mpkendall/orph-pico-reloaded/orphkicad.kicad_pcb

## KiCad design orphkicad.kicad_pcb (2026-01-25)

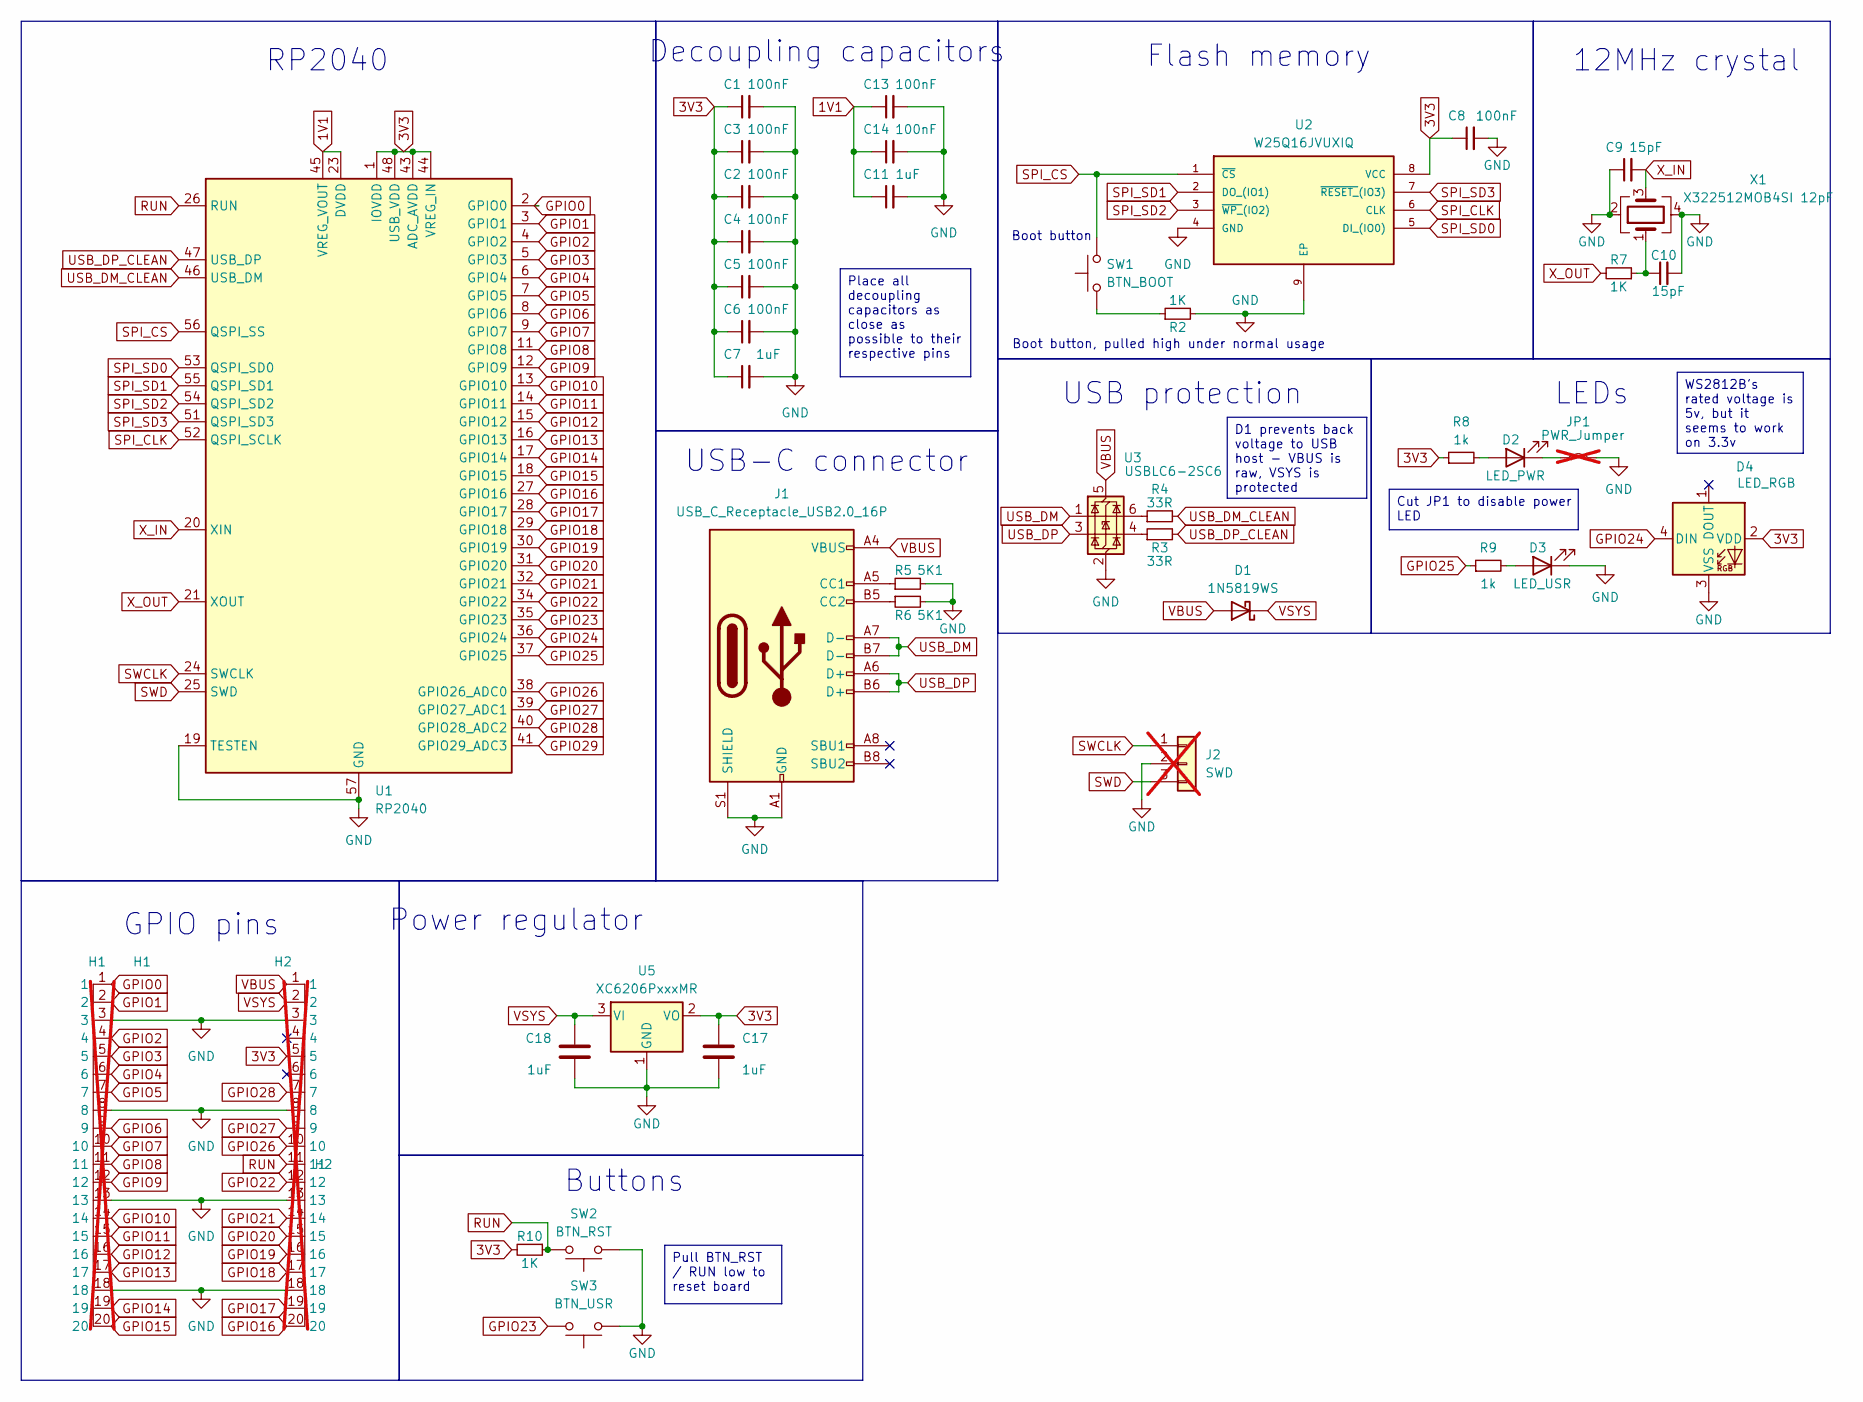
[picture p1: schematic orphkicad.kicad_sch, Orpheus Pico]

Parts:
C1, C2, C3, C4, C5, C6, C8, C13, C14: 100nF; C_0402_1005Metric; LCSC C1525
C7, C11, C17, C18: 1uF; C_0402_1005Metric; LCSC C52923
C9, C10: 15pF; C_0402_1005Metric; LCSC C1548
D1: 1N5819WS; D_SOD-323; LCSC C191023
D2: LED_PWR; LED_0603_1608Metric; LCSC C2286
D3: LED_USR; LED_0603_1608Metric; LCSC C2286
D4: LED_RGB; LED-SMD_4P-L1.6-W1.5_XL-1615RGBC-WS2812B; LCSC C5349954
H1: H1; OrphPicoHeaders; not fitted
H2: H2; OrphPicoHeaders; not fitted
J1: USB_C_Receptacle_USB2.0_16P; USB-C-SMD_TYPE-C-6PIN-2MD-073; LCSC C2765186
J2: SWD; PinHeader_1x03_P2.54mm_Vertical; not fitted
JP1: PWR_Jumper; SolderJumper-2_P1.3mm_Bridged2Bar_RoundedPad1.0x1.5mm; not fitted
R2, R7, R10: 1K; R_0402_1005Metric; LCSC C11702
R3, R4: 33R; R_0402_1005Metric; LCSC C25105
R5, R6: 5K1; R_0402_1005Metric; LCSC C25905
R8, R9: 1k; R_0402_1005Metric; LCSC C11702
SW1: BTN_BOOT; SW-SMD_L3.9-W3.0-P4.45; LCSC C455280
SW2: BTN_RST; SW-SMD_L3.9-W3.0-P4.45; LCSC C455280
SW3: BTN_USR; SW-SMD_L3.9-W3.0-P4.45; LCSC C455280
U1: RP2040; QFN-56-1EP_7x7mm_P0.4mm_EP3.2x3.2mm; LCSC C2040
U2: W25Q16JVUXIQ; Winbond_USON-8-1EP_3x2mm_P0.5mm_EP0.2x1.6mm; MANUFACTURER_PART_NUMBER W25Q16JVUXIQ; LCSC C2843335
U3: USBLC6-2SC6; SOT-23-6; LCSC C5180249
U5: XC6206PxxxMR; SOT-23-3; LCSC C5446
X1: X322512MOB4SI 12pF; Crystal_SMD_3225-4Pin_3.2x2.5mm; LCSC C70565

Connections:
1V1: C11.1, C13.1, C14.1, U1.23 (DVDD), U1.45 (VREG_VOUT), U1.50 (DVDD)
3V3: C1.1, C2.1, C3.1, C4.1, C5.1, C6.1, C7.1, C8.1, C17.1, D4.2 (VDD), H2.5, R8.1, R10.2, U1.1 (IOVDD), U1.10 (IOVDD), U1.22 (IOVDD), U1.33 (IOVDD), U1.42 (IOVDD), U1.43 (ADC_AVDD), U1.44 (VREG_IN), U1.48 (USB_VDD), U1.49 (IOVDD), U2.8 (VCC), U5.2 (VO)
GND: C1.2, C2.2, C3.2, C4.2, C5.2, C6.2, C7.2, C8.2, C9.1, C10.2, C11.2, C13.2, C14.2, C17.2, C18.2, D3.1 (K), D4.3 (VSS), H1.3, H1.8, H1.13, H1.18, H2.3, H2.8, H2.13, H2.18, J1.A1 (GND), J1.B1 (GND), J1.S1 (SHIELD), J2.2, JP1.2 (B), R2.2, R5.2, R6.2, SW2.1, SW3.1, U1.19 (TESTEN), U1.57 (GND), U2.4 (GND), U2.9 (EP), U3.2 (GND), U5.1 (GND), X1.2, X1.4
GPIO0: H1.1, U1.2 (GPIO0)
GPIO1: H1.2, U1.3 (GPIO1)
GPIO2: H1.4, U1.4 (GPIO2)
GPIO3: H1.5, U1.5 (GPIO3)
GPIO4: H1.6, U1.6 (GPIO4)
GPIO5: H1.7, U1.7 (GPIO5)
GPIO6: H1.9, U1.8 (GPIO6)
GPIO7: H1.10, U1.9 (GPIO7)
GPIO8: H1.11, U1.11 (GPIO8)
GPIO9: H1.12, U1.12 (GPIO9)
GPIO10: H1.14, U1.13 (GPIO10)
GPIO11: H1.15, U1.14 (GPIO11)
GPIO12: H1.16, U1.15 (GPIO12)
GPIO13: H1.17, U1.16 (GPIO13)
GPIO14: H1.19, U1.17 (GPIO14)
GPIO15: H1.20, U1.18 (GPIO15)
GPIO16: H2.20, U1.27 (GPIO16)
GPIO17: H2.19, U1.28 (GPIO17)
GPIO18: H2.17, U1.29 (GPIO18)
GPIO19: H2.16, U1.30 (GPIO19)
GPIO20: H2.15, U1.31 (GPIO20)
GPIO21: H2.14, U1.32 (GPIO21)
GPIO22: H2.12, U1.34 (GPIO22)
GPIO23: SW3.2, U1.35 (GPIO23)
GPIO24: D4.4 (DIN), U1.36 (GPIO24)
GPIO25: R9.1, U1.37 (GPIO25)
GPIO26: H2.10, U1.38 (GPIO26_ADC0)
GPIO27: H2.9, U1.39 (GPIO27_ADC1)
GPIO28: H2.7, U1.40 (GPIO28_ADC2)
GPIO29: U1.41 (GPIO29_ADC3)
unnamed: C10.1, R7.1, X1.1
unnamed: D2.2 (A), R8.2
unnamed: D2.1 (K), JP1.1 (A)
unnamed: D3.2 (A), R9.2
unnamed: J1.A5 (CC1), R5.1
unnamed: J1.B5 (CC2), R6.1
unnamed: R2.1, SW1.1
unnamed: R3.1, U3.4 (I/O2)
unnamed: R4.1, U3.6 (I/O1)
RUN: H2.11, R10.1, SW2.2, U1.26 (RUN)
SPI_CLK: U1.52 (QSPI_SCLK), U2.6 (CLK)
SPI_CS: SW1.2, U1.56 (QSPI_SS), U2.1 (~CS)
SPI_SD0: U1.53 (QSPI_SD0), U2.5 (DI_(IO0))
SPI_SD1: U1.55 (QSPI_SD1), U2.2 (DO_(IO1))
SPI_SD2: U1.54 (QSPI_SD2), U2.3 (~WP_(IO2))
SPI_SD3: U1.51 (QSPI_SD3), U2.7 (~RESET_(IO3))
SWCLK: J2.1, U1.24 (SWCLK)
SWD: J2.3, U1.25 (SWD)
USB_DM: J1.A7 (D-), J1.B7 (D-), U3.1 (I/O1)
USB_DM_CLEAN: R4.2, U1.46 (USB_DM)
USB_DP: J1.A6 (D+), J1.B6 (D+), U3.3 (I/O2)
USB_DP_CLEAN: R3.2, U1.47 (USB_DP)
VBUS: D1.2 (A), H2.1, J1.A4 (VBUS), J1.B4 (VBUS), U3.5 (VBUS)
VSYS: C18.1, D1.1 (K), H2.2, U5.3 (VI)
X_IN: C9.2, U1.20 (XIN), X1.3
X_OUT: R7.2, U1.21 (XOUT)

Notes on the sheet:
Power regulator
Flash memory
Boot button, pulled high under normal usage
USB-C connector
Decoupling capacitors
USB protection
LEDs
Boot button
RP2040
GPIO pins
Buttons
12MHz crystal
Pull BTN_RST / RUN low to reset board
Place all decoupling capacitors as close as possible to their respective pins
WS2812B's rated voltage is 5v, but it seems to work on 3.3v
Cut JP1 to disable power LED
D1 prevents back voltage to USB host - VBUS is raw, VSYS is protected

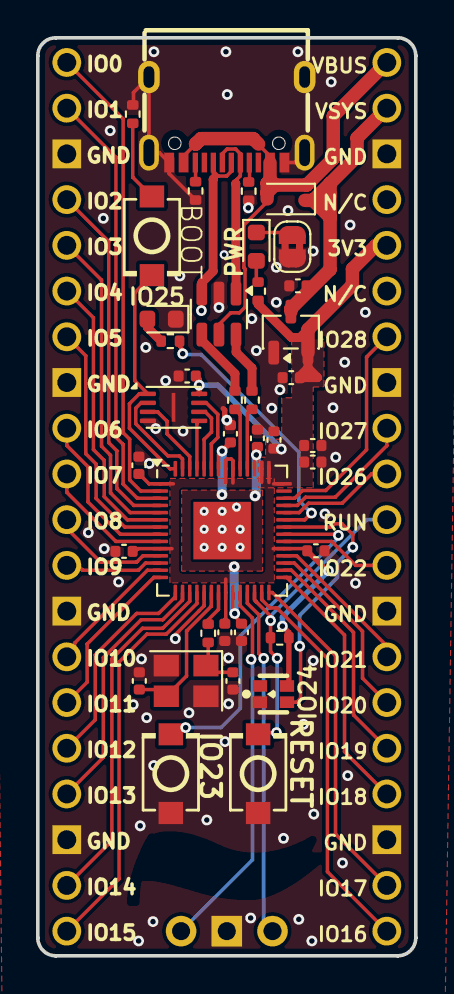
[picture p2: board orphkicad.kicad_pcb from above]

Board: 2 copper layers, 21.0 x 51.0 mm, 41 parts (0 on the bottom side), 58 nets.
