mpkendall/orph-pico-reloaded/testboard/testboard/testboard.kicad_pcb

## KiCad design testboard/testboard/testboard.kicad_pcb (2026-01-20)

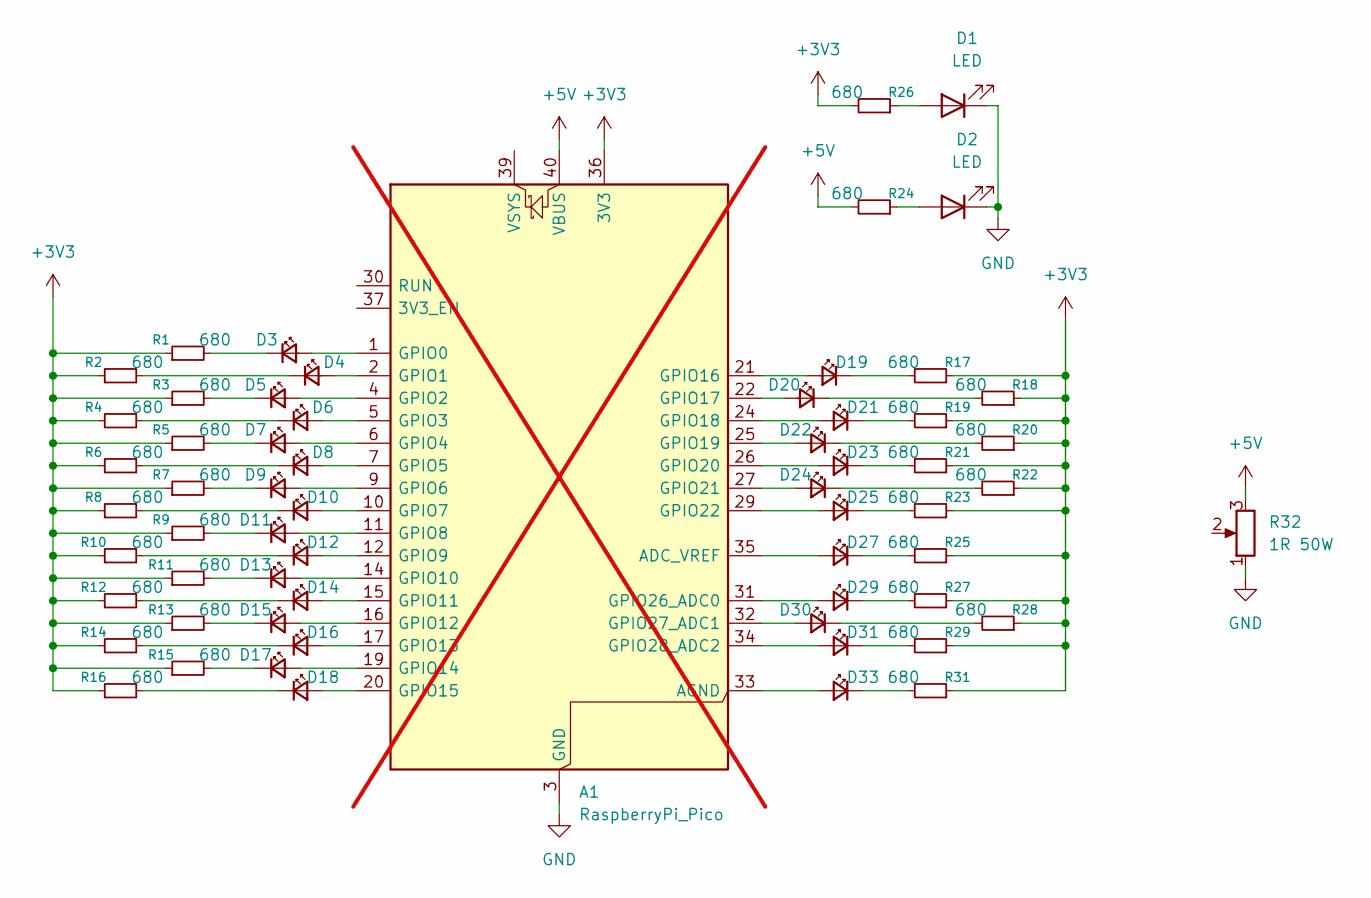
[picture p3: schematic testboard.kicad_sch]

Parts:
A1: RaspberryPi_Pico; RaspberryPi_Pico_Common_THT; not fitted
D1, D2, D3, D4, D5, D6, D7, D8, D9, D10, D11, D12, D13, D14, D15, D16, D17, D18, D19, D20, D21, D22, D23, D24, D25, D27, D29, D30, D31, D33: LED; LED_0603_1608Metric; LCSC Part # C2290
R1, R2, R3, R4, R5, R6, R7, R8, R9, R10, R11, R12, R13, R14, R15, R16, R17, R18, R19, R20, R21, R22, R23, R24, R25, R26, R27, R28, R29, R31: 680; R_0603_1608Metric; LCSC Part # C23228
R32: 1R 50W; TO-263-2; LCSC Part # C39221240

Connections:
+3V3: A1.36 (3V3), R1.1, R2.1, R3.1, R4.1, R5.1, R6.1, R7.1, R8.1, R9.1, R10.1, R11.1, R12.1, R13.1, R14.1, R15.1, R16.1, R17.1, R18.1, R19.1, R20.1, R21.1, R22.1, R23.1, R25.1, R26.2, R27.1, R28.1, R29.1, R31.1
+5V: A1.40 (VBUS), R24.2, R32.3
GND: A1.3 (GND), A1.8 (GND), A1.13 (GND), A1.18 (GND), A1.23 (GND), A1.28 (GND), A1.38 (GND), D1.1 (K), D2.1 (K), R32.1
unnamed: A1.35 (ADC_VREF), D27.2 (A)
unnamed: A1.33 (AGND), D33.2 (A)
unnamed: A1.1 (GPIO0), D3.2 (A)
unnamed: A1.2 (GPIO1), D4.2 (A)
unnamed: A1.4 (GPIO2), D5.2 (A)
unnamed: A1.5 (GPIO3), D6.2 (A)
unnamed: A1.6 (GPIO4), D7.2 (A)
unnamed: A1.7 (GPIO5), D8.2 (A)
unnamed: A1.9 (GPIO6), D9.2 (A)
unnamed: A1.10 (GPIO7), D10.2 (A)
unnamed: A1.11 (GPIO8), D11.2 (A)
unnamed: A1.12 (GPIO9), D12.2 (A)
unnamed: A1.14 (GPIO10), D13.2 (A)
unnamed: A1.15 (GPIO11), D14.2 (A)
unnamed: A1.16 (GPIO12), D15.2 (A)
unnamed: A1.17 (GPIO13), D16.2 (A)
unnamed: A1.19 (GPIO14), D17.2 (A)
unnamed: A1.20 (GPIO15), D18.2 (A)
unnamed: A1.21 (GPIO16), D19.2 (A)
unnamed: A1.22 (GPIO17), D20.2 (A)
unnamed: A1.24 (GPIO18), D21.2 (A)
unnamed: A1.25 (GPIO19), D22.2 (A)
unnamed: A1.26 (GPIO20), D23.2 (A)
unnamed: A1.27 (GPIO21), D24.2 (A)
unnamed: A1.29 (GPIO22), D25.2 (A)
unnamed: A1.31 (GPIO26_ADC0), D29.2 (A)
unnamed: A1.32 (GPIO27_ADC1), D30.2 (A)
unnamed: A1.34 (GPIO28_ADC2), D31.2 (A)
unnamed: D1.2 (A), R26.1
unnamed: D2.2 (A), R24.1
unnamed: D3.1 (K), R1.2
unnamed: D4.1 (K), R2.2
unnamed: D5.1 (K), R3.2
unnamed: D6.1 (K), R4.2
unnamed: D7.1 (K), R5.2
unnamed: D8.1 (K), R6.2
unnamed: D9.1 (K), R7.2
unnamed: D10.1 (K), R8.2
unnamed: D11.1 (K), R9.2
unnamed: D12.1 (K), R10.2
unnamed: D13.1 (K), R11.2
unnamed: D14.1 (K), R12.2
unnamed: D15.1 (K), R13.2
unnamed: D16.1 (K), R14.2
unnamed: D17.1 (K), R15.2
unnamed: D18.1 (K), R16.2
unnamed: D19.1 (K), R17.2
unnamed: D20.1 (K), R18.2
unnamed: D21.1 (K), R19.2
unnamed: D22.1 (K), R20.2
unnamed: D23.1 (K), R21.2
unnamed: D24.1 (K), R22.2
unnamed: D25.1 (K), R23.2
unnamed: D27.1 (K), R25.2
unnamed: D29.1 (K), R27.2
unnamed: D30.1 (K), R28.2
unnamed: D31.1 (K), R29.2
unnamed: D33.1 (K), R31.2

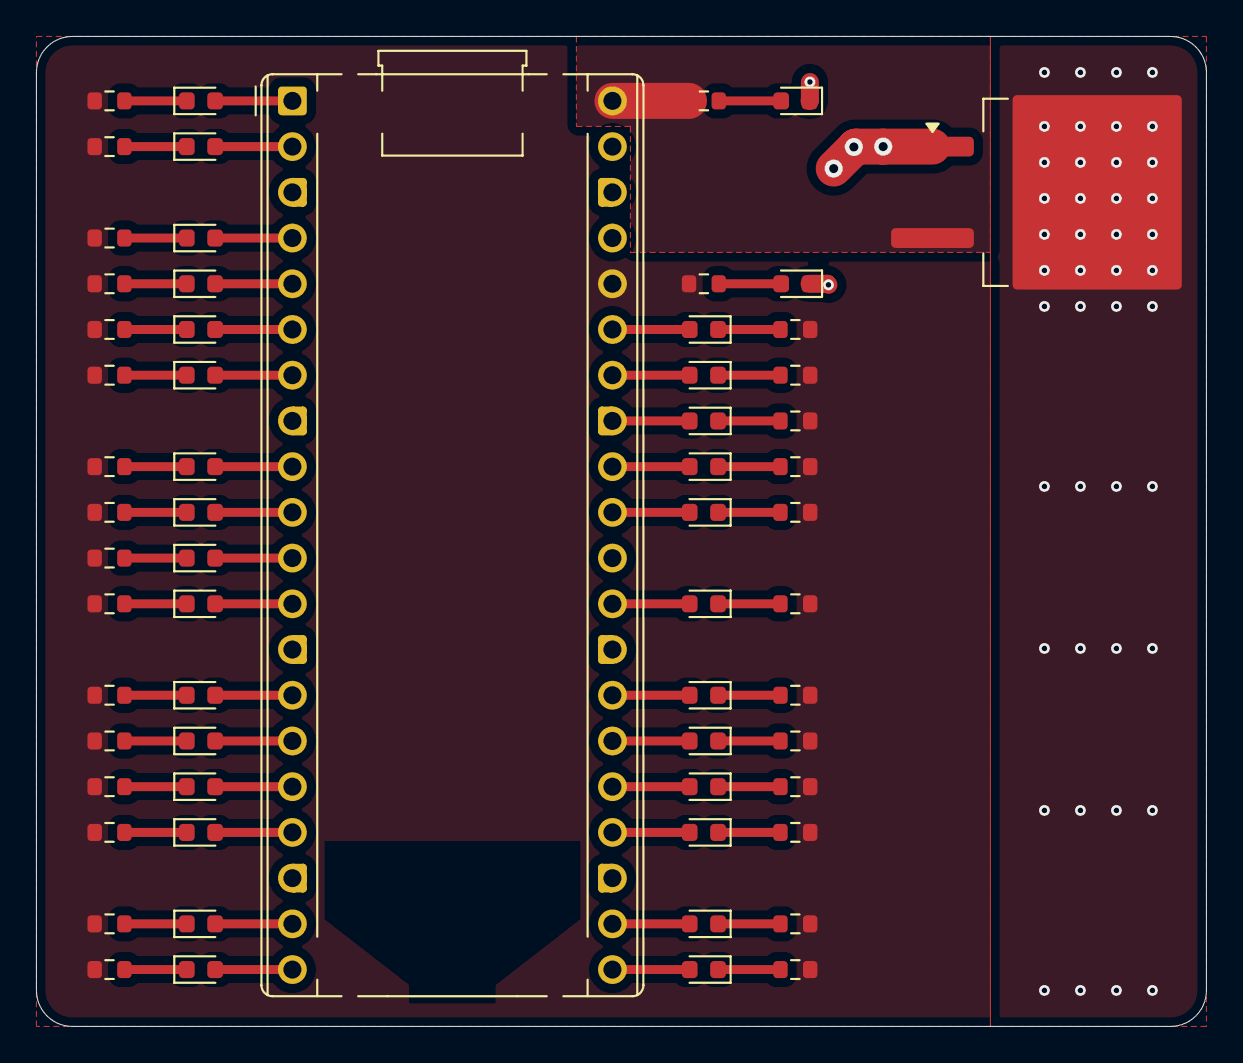
[picture p4: board testboard.kicad_pcb from above]

Board: 2 copper layers, 65.0 x 55.0 mm, 62 parts (0 on the bottom side), 61 nets.
