mpkendall/orph-pico-reloaded/(commit log)

2026-01-11 improve routing on esd protection ic
    [orphkicad.kicad_pcb]
2026-01-18 minor fixes + stitching vias
    [orphkicad.kicad_pcb]
2026-01-19 make field show up nice
    [orphkicad.kicad_sch]
2026-01-19 updated dnp
    [orphkicad.kicad_pcb, orphkicad.kicad_sch]
2026-01-20 Test board and fix silk
    [orphkicad.kicad_pcb, orphkicad.kicad_sch, testboard.kicad_pcb, testboard.kicad_sch]
2026-01-21 fix silkscreen label
    [orphkicad.kicad_pcb]
2026-01-25 Move BOOT label
    [bom.csv, orphkicad.kicad_pcb, positions.csv]
2026-01-25 Remove extra space from LCSC Part #
    [bom.csv, orphkicad.kicad_pcb, orphkicad.kicad_sch]
